GeertGiebens/LocoNet_IO/README.md

# LocoNet_IO

This LocoNet project has moved to this link: [DIY LocoNet S88 DCC](https://github.com/GeertGiebens/DIY_LocoNet_S88_DCC/)
