GeertGiebens/LocoNet_IO/Belgisch sein soldeerhulp 3.pdf

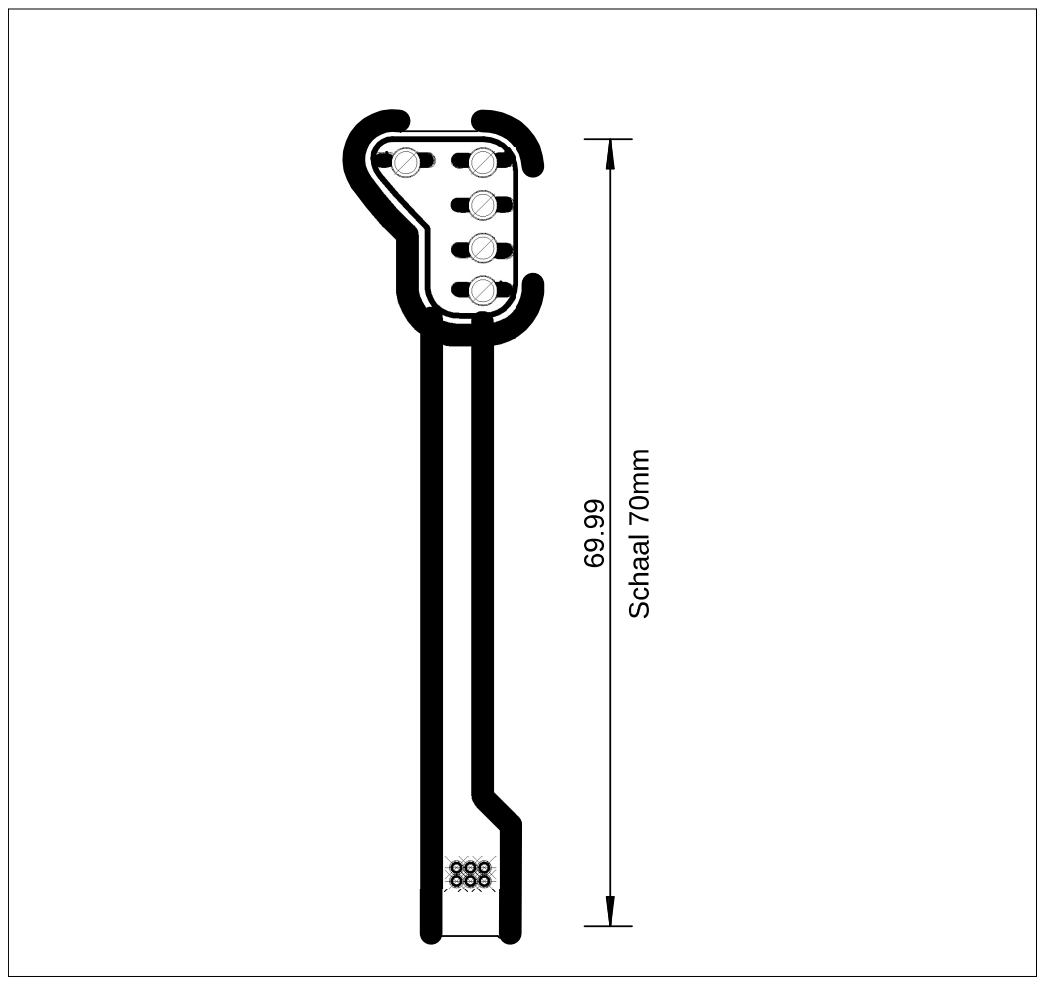
[picture p10: page 1]
