GeertGiebens/LocoNet_IO/Loconet in-out v3.brd

## EAGLE design Loconet in-out v3.brd (2018-12-20, last stored version)

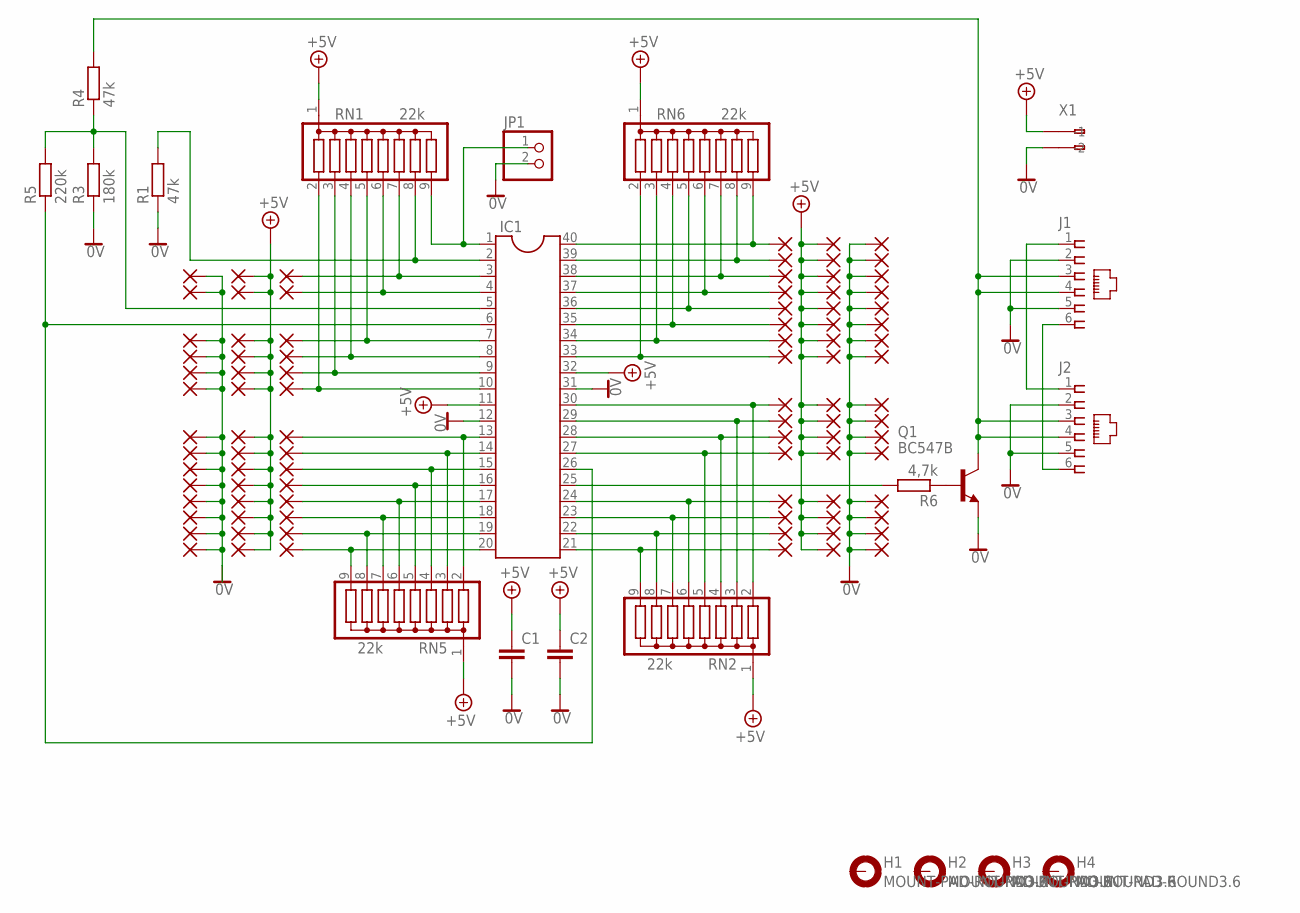
[picture p11: schematic Loconet in-out v3.sch]

Parts:
0, 2, 3, 4, 5, 6, 7, 8, 9, 10, 11, 12, 13, 14, 15, 16, 17, 18, 19, 20, 21, 22, 23, 24, 25, 26, 27, 28, 29, 30: 2,15/1,0
1: 1; 2,15/1,0
C1, C2: C-EU025-024X044; C025-024X044
H1, H2, H3, H4: MOUNT-PAD-ROUND3.6; 3,6-PAD
IC1: DIL40
J1, J2: 520250-3
JP1: PINHD-1X2; 1X02
PAD1, PAD2, PAD3, PAD4, PAD5, PAD6, PAD7, PAD8, PAD9, PAD10, PAD11, PAD12, PAD13, PAD14, PAD15, PAD16, PAD17, PAD18, PAD19, PAD20, PAD21, PAD22, PAD23, PAD24, PAD25, PAD26, PAD27, PAD28, PAD29, PAD30, PAD33, PAD35, PAD37, PAD39, PAD41, PAD43, PAD52, PAD53, PAD54, PAD55, PAD56, PAD57, PAD58, PAD59, PAD60, PAD61, PAD62, PAD63, PAD64, PAD65, PAD66, PAD67, PAD68, PAD69, PAD70, PAD71, PAD72, PAD73, PAD74: 2,15/1,0
Q1: BC547B; TO92
R1, R4: 47k; 0204/7
R3: 180k; 0204/7
R5: 220k; 0204/7
R6: 4,7k; 0204/7
RN1, RN2, RN5, RN6: 22k; SIL9
X1: 233-102

Connections:
+5V: 0.1, C1.1, C2.1, IC1.11, IC1.32, PAD33.1, PAD35.1, PAD37.1, PAD39.1, PAD41.1, PAD43.1, PAD52.1, PAD53.1, PAD54.1, PAD55.1, PAD56.1, PAD57.1, PAD58.1, PAD59.1, PAD60.1, PAD61.1, PAD62.1, PAD63.1, PAD64.1, PAD65.1, PAD66.1, PAD67.1, PAD68.1, PAD69.1, PAD70.1, PAD71.1, PAD72.1, PAD73.1, PAD74.1, RN1.1, RN2.1, RN5.1, RN6.1, X1.A1 (-1)
LN_RECEIVER: IC1.6, IC1.26, R5.1
LOCONET: J1.3, J1.4, J2.3, J2.4, Q1.3 (C), R4.2
unnamed: IC1.2, R1.2, RN1.8
unnamed: IC1.5, R3.2, R4.1, R5.2
unnamed: IC1.23, PAD20.1, RN2.7
unnamed: Q1.2 (B), R6.1
unnamed: J1.1, J2.1
unnamed: IC1.1, JP1.1, RN1.9
unnamed: IC1.40, PAD7.1, RN6.9
unnamed: J1.6, J2.6
unnamed: IC1.39, PAD8.1, RN6.8
unnamed: IC1.3, PAD1.1, RN1.7
unnamed: IC1.4, PAD2.1, RN1.6
unnamed: IC1.10, PAD6.1, RN1.2
unnamed: IC1.9, PAD5.1, RN1.3
unnamed: IC1.8, PAD4.1, RN1.4
unnamed: IC1.7, PAD3.1, RN1.5
unnamed: IC1.33, PAD14.1, RN6.2
unnamed: IC1.34, PAD13.1, RN6.3
unnamed: IC1.35, PAD12.1, RN6.4
unnamed: IC1.36, PAD11.1, RN6.5
unnamed: IC1.37, PAD10.1, RN6.6
unnamed: IC1.38, PAD9.1, RN6.7
unnamed: IC1.21, PAD22.1, RN2.9
unnamed: IC1.22, PAD21.1, RN2.8
unnamed: IC1.24, PAD19.1, RN2.6
unnamed: IC1.27, PAD18.1, RN2.5
unnamed: IC1.28, PAD17.1, RN2.4
unnamed: IC1.29, PAD16.1, RN2.3
unnamed: IC1.30, PAD15.1, RN2.2
unnamed: IC1.20, PAD23.1, RN5.9
unnamed: IC1.19, PAD24.1, RN5.8
unnamed: IC1.18, PAD25.1, RN5.7
unnamed: IC1.17, PAD26.1, RN5.6
unnamed: IC1.16, PAD27.1, RN5.5
unnamed: IC1.15, PAD28.1, RN5.4
unnamed: IC1.14, PAD29.1, RN5.3
unnamed: IC1.13, PAD30.1, RN5.2
unnamed: IC1.25, R6.2
unnamed: 1.1, 2.1, 3.1, 4.1, 5.1, 6.1, 7.1, 8.1, 9.1, 10.1, 11.1, 12.1, 13.1, 14.1, 15.1, 16.1, 17.1, 18.1, 19.1, 20.1, 21.1, 22.1, 23.1, 24.1, 25.1, 26.1, 27.1, 28.1, 29.1, 30.1, C1.2, C2.2, IC1.12, IC1.31, J1.2, J1.5, J2.2, J2.5, JP1.2, Q1.1 (E), R1.1, R3.1, X1.A2 (-2)

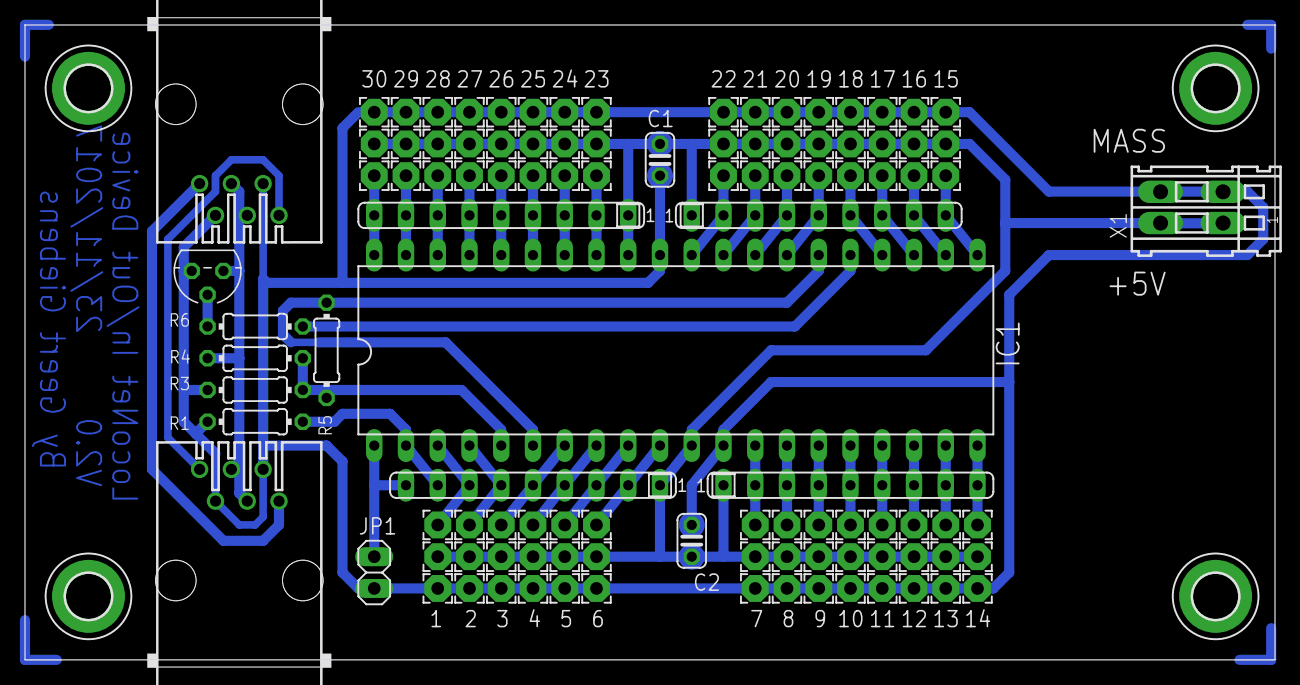
[picture p12: board Loconet in-out v3.brd from above]

Board: 2 copper layers, 100.0 x 50.8 mm, 111 parts (0 on the bottom side), 41 nets.
