GeertGiebens/LocoNet_IO/(threads)

Thread 1 (2020-03-16):

Problem

Digtrain, 2020-03-16:
Hi Geert, I built your device, but after but after some setting of the pins, the fields are disabled,
only the field "Device" and the next field on the right of the button "Reset Device" are enable.
The title of the python file is LocoNet IO V1p61, but it contains version p60.
What do you think about?
Regards Walter
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

GeertGiebens, 2020-03-16:
I also have this problem sometimes. it helps to close and restart the
python file. I suspect what it might be, but I don't have a solution
yet. I'll keep you informed.

Geert Giebens

Openen in Google Translate
<https://translate.google.be/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,%20maar%20heb%20er%20nog%20geen%20oplossing%20voor.%20ik%20hou%20je%20op%20de%20hoogte.%0A%0AGeert%20Giebens>
Feedback
<https://www.google.be/search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>
Webresultaten

Google Translate
translate.google.com › ...
<https://translate.google.com/?hl=nl>
<https://www.google.be/search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>

   1.
   <https://webcache.googleusercontent.com/search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>
   2.
   <https://www.google.be/search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>

De gratis service van Google kan woorden, zinnen en webpagina's
onmiddellijk vertalentussen het Engels en meer dan 100 andere talen.

Vertaler - Online zinnen vertalen - Engels, Duits, Spaans ...
www.vertalen.nu › zinnen
<https://www.vertalen.nu/zinnen/>
<https://www.google.be/search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>

   1.
   <https://webcache.googleusercontent.com/search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>

Automatische vertaling van tekst in tientallen talen. Welke tekst wil je
vertalen? 1500 karakters resterend. Nederlands, Engels, Duits, Frans,
Spaans, Italiaans ...
‎Zinnenboek <https://www.vertalen.nu/zinnenboek/> · ‎Woordenboek
<https://www.vertalen.nu/woordenboek/> · ‎Mijn Vertalen.nu
<https://www.vertalen.nu/voordelen-account/>

DeepL Translator
www.deepl.com › translator
<https://www.deepl.com/nl/translator>
<https://www.google.be/search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>

   1.
   <https://webcache.googleusercontent.com/search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>

Gebruik de gratis DeepL Translator om uw teksten te vertalen met de best
... Op dit moment worden de volgende talen ondersteund: Engels, Duits,
Frans, ...

Engels - Vertaling Nederlands-Engels - Mijnwoordenboek
www.mijnwoordenboek.nl › vertaal › Engels
<https://www.mijnwoordenboek.nl/vertaal/NL/EN/Engels>
<https://www.google.be/search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>

   1.
   <https://webcache.googleusercontent.com/search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>

I het Engels. zelfst.naamw. Uitspraak: [ˈɛŋəls]. de Engelse taal - English.
Engels spreken - speak ...

Vertaal woorden en uitdrukkingen in Nederlands-Engels
context.reverso.net › vertaling › nederlands-engels
<https://context.reverso.net/vertaling/nederlands-engels/>
<https://www.google.be/search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>

   1.
   <https://webcache.googleusercontent.com/search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>

Verkrijg vertalingen in context naar het Engels van woorden, uitdrukkingen
en zegswijzen in het Nederlands; een gratis woordenboek Nederlands-Engels
 met ...

vertaal - Engelse vertaling - bab.la Nederlands-Engels ...
nl.bab.la › woordenboek › nederlands-engels › vertaal
<https://nl.bab.la/woordenboek/nederlands-engels/vertaal>
<https://www.google.be/search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>

   1.
   <https://webcache.googleusercontent.com/search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>

Vertalingen van 'vertaal' in het gratis Nederlands-Engels woordenboek en
vele andere Engelse vertalingen.

bevatten - Engelse vertaling - bab.la Nederlands-Engels ...
nl.bab.la › woordenboek › nederlands-engels › bevatten
<https://nl.bab.la/woordenboek/nederlands-engels/bevatten>
<https://www.google.be/search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>

   1.
   <https://webcache.googleusercontent.com/search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>

Vertalingen van 'bevatten' in het gratis Nederlands-Engels woordenboek en
vele andere Engelse vertalingen.

Linguee | Nederlands-Engels woordenboek (en andere talen)
www.linguee.nl
<https://www.linguee.nl/>
<https://www.google.be/search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>

   1.
   <https://webcache.googleusercontent.com/search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>

Opzoeken in Linguee; Als vertaling van "" voorstellen; Kopiëren. DeepL
Translator Linguee. NL. Open menu. Engels-Nederlands woordenboek. Zoek door
een ...

Bewust in het Engels vertaald uit het Nederlands - InterGlot.com
www.interglot.nl › woordenboek › vertaal › bewust
<https://www.interglot.nl/woordenboek/nl/en/vertaal/bewust>
<https://www.google.be/search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>

   1.
   <https://webcache.googleusercontent.com/search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>

"bewust" Vertaald van Nederlands naar Engels inclusief synoniemen, uitleg
en gerelateerde woorden. ... Vertaal bewust van Nederlands naar Engels.
Zoek.

Tekst vertalen en gratis online | TRANSLATOR.EU
www.translator.eu › nederlands
<https://www.translator.eu/nederlands/>
<https://www.google.be/search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>

   1.
   <https://webcache.googleusercontent.com/search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>
   2.
   <https://www.google.be/search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>

 Beoordeling: 4,7 - ‎169 stemmen
Tekst van. nederlands. Vertalen in. engels. language swap.
Zoekopdrachten gerelateerd aan vertaal engels

*vertalen nederlands* engels *teksten*
<https://www.google.be/search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>

*vertalen tekst*
<https://www.google.be/search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>

*vertalen nederlands duits*
<https://www.google.be/search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>

*vertalen frans*
<https://www.google.be/search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>

*vertalen nederlands spaans*
<https://www.google.be/search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>

*vertalen nederlands frans*
<https://www.google.be/search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>

*woord* engels *vertalen*
<https://www.google.be/search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>

*gratis vertalen frans*
<https://www.google.be/search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>
Paginanavigatie
1 2
<https://www.google.be/search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>
3
<https://www.google.be/search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>
Volgende
<https://www.google.be/search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>

Op ma 16 mrt. 2020 om 19:40 schreef Digtrain <notifications@github.com>

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

GeertGiebens, 2020-03-16:
try this version?

Op ma 16 mrt. 2020 om 20:09 schreef Geert Giebens <geert.giebens@gmail.com>:

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

GeertGiebens, 2020-03-16:
this is better, sorry:

Op ma 16 mrt. 2020 om 20:17 schreef Geert Giebens <geert.giebens@gmail.com>:

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

Thread 2 (2022-05-02):

Vraag

JWvP, 2022-05-02:
Hi Geert,

In mijn zoektocht naar een mooie zelfbouw oplossing voor het digitaliseren van mijn modelbaan was ik bij jouw LocoNet_IO uitgekomen.
Echter zie ik dat je die repo nu opgedoekt hebt en door bent gegaan met een eenvoudigere variant. Mijn vraag is of daar een technische reden toe was (zoals performance)? Ik heb 10 van die printplaten liggen, maar ik vind het zonde om de onderdelen om die daarvoor te gebruiken als het advies is om over te stappen naar de 16 input/output variant.

Met vriendelijke groet,

Jan-Willem

GeertGiebens, 2022-05-10:
Hoi Jan-Willem,

het spijt me dat je nu met 10 printplaten zit. Het was de bedoeling deze
versie  op die pagina wat op te kuisen, maar dat gaat wat trager dan ik
zelf had verwacht (vorig jaar een hersenbloeding gehad waar ik nu nog de
gevolgen van ondervindt). Heb even geduld, of ik stuur de code zoals deze
het laatste werkte door ?

Groetjes,

Geert

Op ma 2 mei 2022 om 10:08 schreef JWvP ***@***.***>:

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

JWvP, 2022-05-10:
Hi Geert, helemaal geen probleem!
Ik was vooral benieuwd naar het waarom van de eenvoudigere versie en of je advies is om daar naar toe over te stappen.
Ben zelf nog aan het experimenteren met de loconet_io variant en bezig de stroomdetectie schakeling te maken.
Maar als je nieuwere code hebt is die van harte welkom natuurlijk.
Jeetje, heftig! Als ik ergens mee kan helpen hoor ik het graag. Ben niet heel bedreven met python en assembly is nieuw voor me, maar ik ben er ook niet vies van iets nieuws te proberen en te leren.
